sebastianbeyer/KOSMO_Roundhouse/kickall.kicad_pcb

## KiCad design kickall.kicad_pcb (2022-11-23)

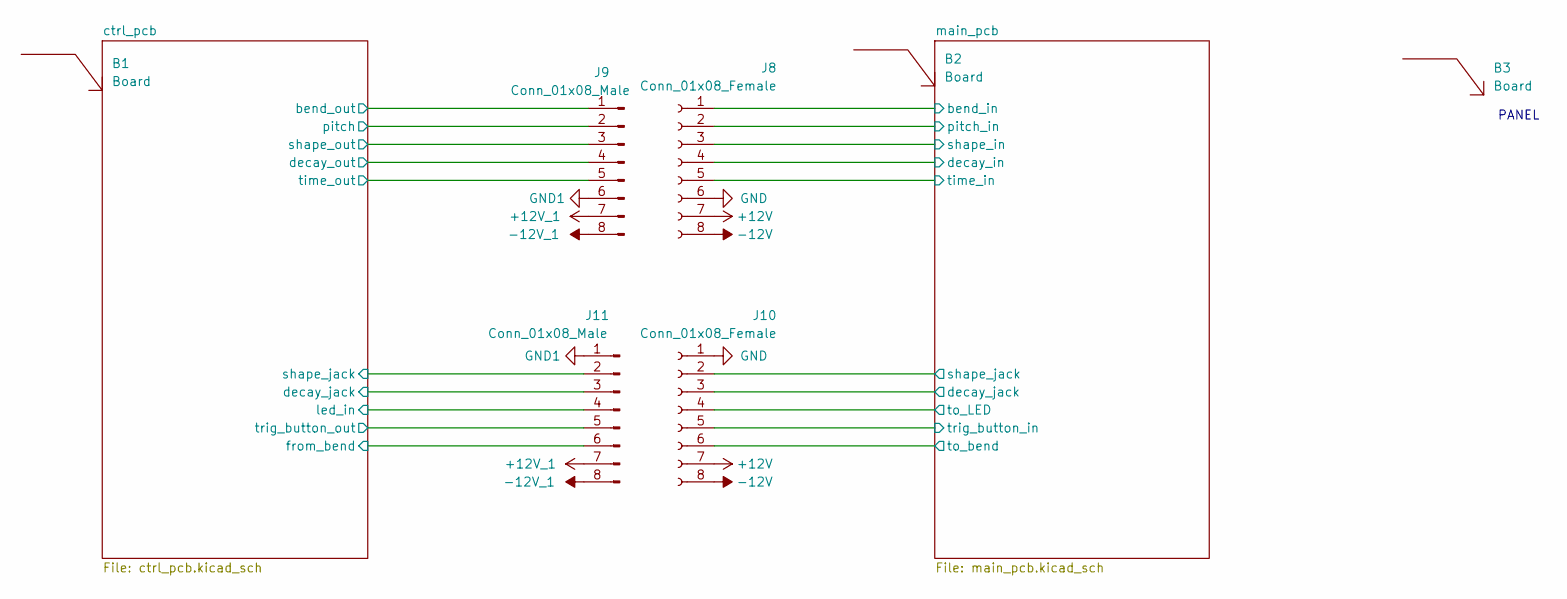
[picture p1: schematic kickall.kicad_sch, Roundhouse]

Parts:
B1, B2, B3: Board; Board_Marker
J8, J10: Conn_01x08_Female; PinSocket_1x08_P2.54mm_Vertical
J9, J11: Conn_01x08_Male; PinHeader_1x08_P2.54mm_Vertical

Connections:
+12V: J8.7, J10.7; also elsewhere on the board
+12V_1: J9.7, J11.7; also elsewhere on the board
-12V: J8.8, J10.8; also elsewhere on the board
-12V_1: J9.8, J11.8; also elsewhere on the board
/ctrl_pcb/bend_out: J9.1; also elsewhere on the board
/ctrl_pcb/decay_jack: J11.3; also elsewhere on the board
/ctrl_pcb/decay_out: J9.4; also elsewhere on the board
/ctrl_pcb/from_bend: J11.6; also elsewhere on the board
/ctrl_pcb/led_in: J11.4; also elsewhere on the board
/ctrl_pcb/pitch: J9.2; also elsewhere on the board
/ctrl_pcb/shape_jack: J11.2; also elsewhere on the board
/ctrl_pcb/shape_out: J9.3; also elsewhere on the board
/ctrl_pcb/time_out: J9.5; also elsewhere on the board
/ctrl_pcb/trig_button_out: J11.5; also elsewhere on the board
/main_pcb/bend_in: J8.1; also elsewhere on the board
/main_pcb/decay_in: J8.4; also elsewhere on the board
/main_pcb/decay_jack: J10.3; also elsewhere on the board
/main_pcb/pitch_in: J8.2; also elsewhere on the board
/main_pcb/shape_in: J8.3; also elsewhere on the board
/main_pcb/shape_jack: J10.2; also elsewhere on the board
/main_pcb/time_in: J8.5; also elsewhere on the board
/main_pcb/to_LED: J10.4; also elsewhere on the board
/main_pcb/to_bend: J10.6; also elsewhere on the board
/main_pcb/trig_button_in: J10.5; also elsewhere on the board
GND: J8.6, J10.1; also elsewhere on the board
GND1: J9.6, J11.1; also elsewhere on the board

Notes on the sheet:
PANEL

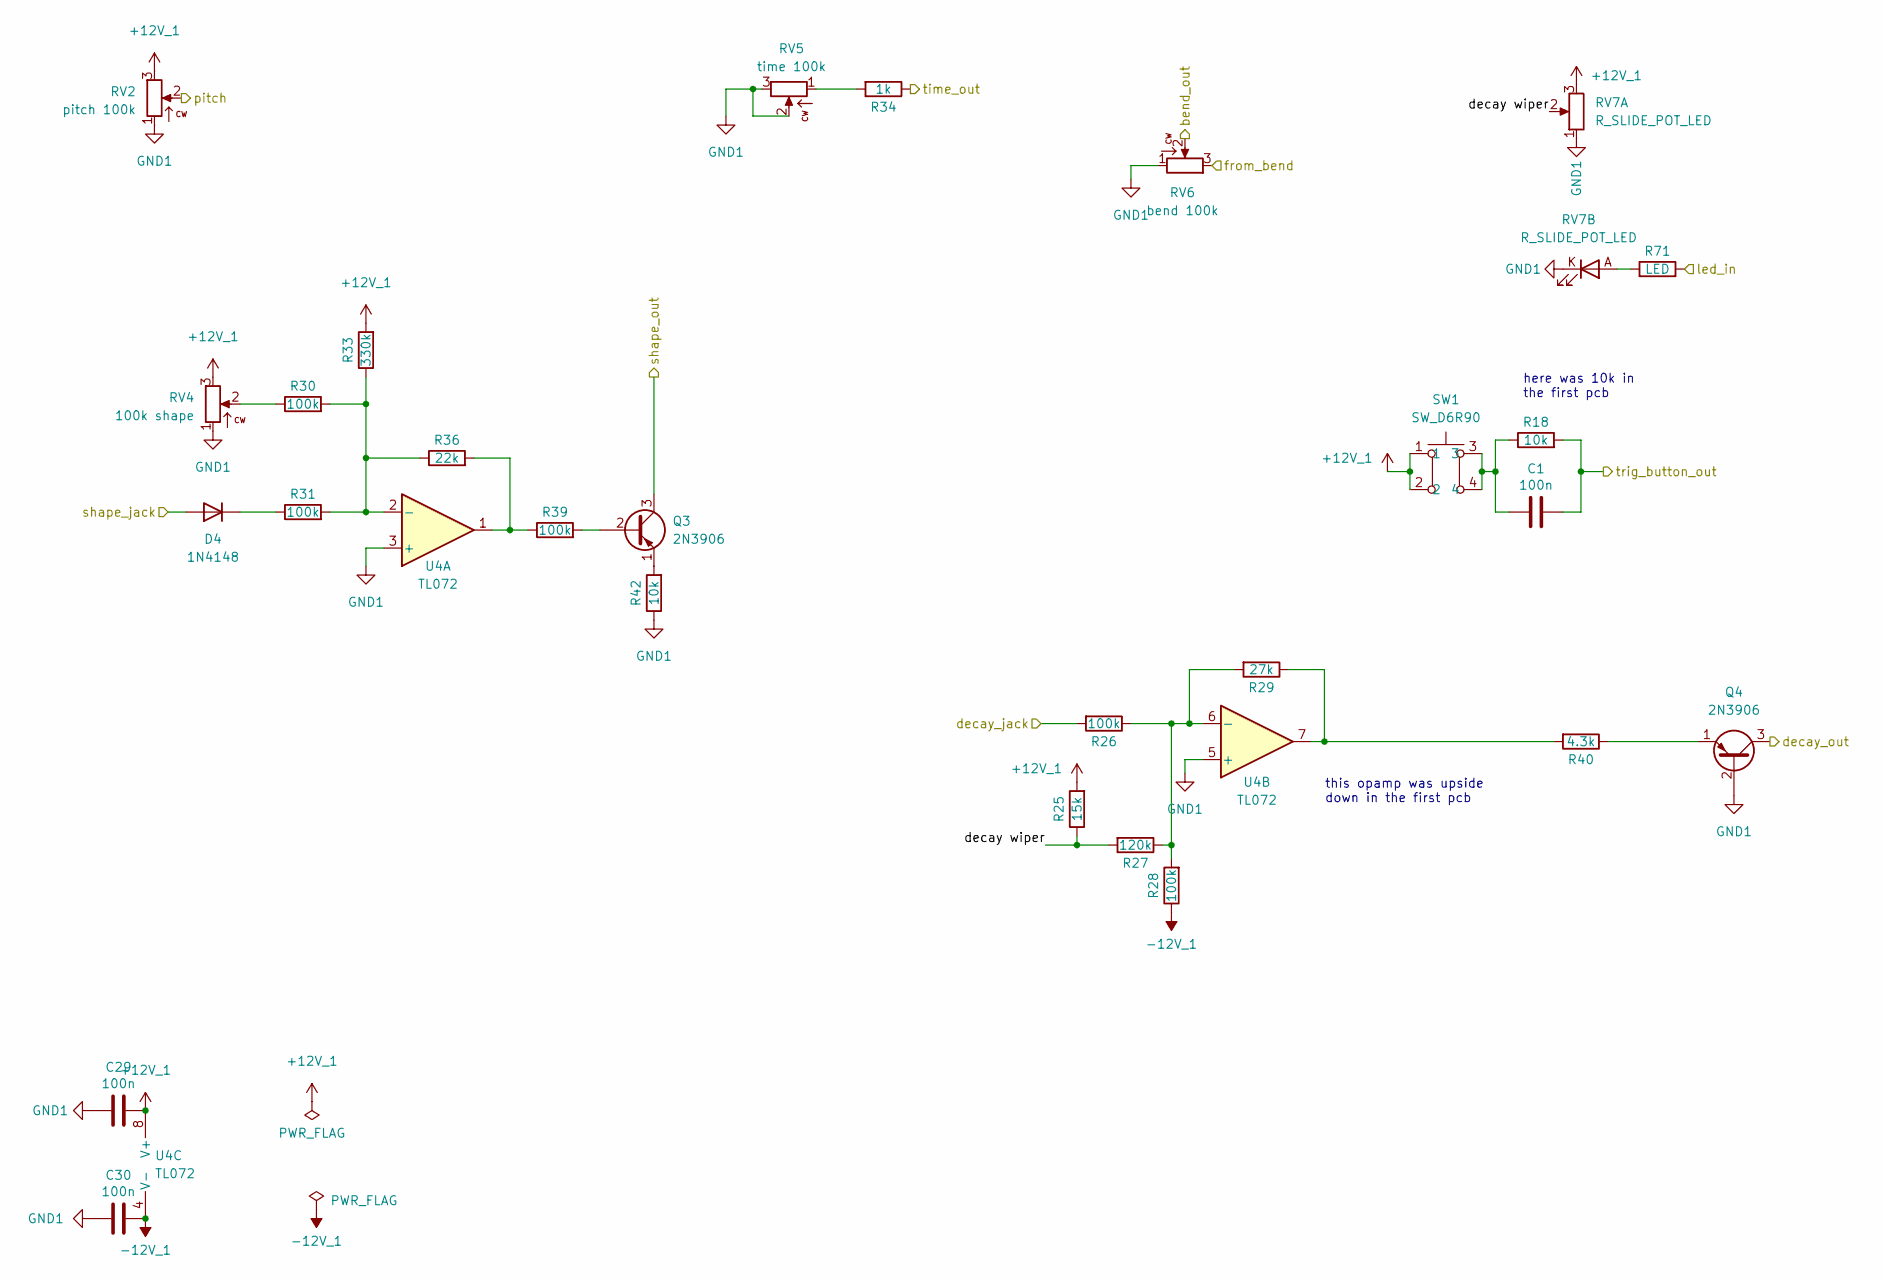
[picture p2: schematic ctrl_pcb.kicad_sch]

Parts:
C1, C29, C30: 100n; C_Disc_D3.0mm_W1.6mm_P2.50mm
D4: 1N4148; D_DO-35_SOD27_P7.62mm_Horizontal
Q3, Q4: 2N3906; TO-92_Inline_Wide
R18, R42: 10k; R_Axial_DIN0207_L6.3mm_D2.5mm_P10.16mm_Horizontal
R25: 15k; R_Axial_DIN0207_L6.3mm_D2.5mm_P10.16mm_Horizontal
R26, R28, R30, R31, R39: 100k; R_Axial_DIN0207_L6.3mm_D2.5mm_P10.16mm_Horizontal
R27: 120k; R_Axial_DIN0207_L6.3mm_D2.5mm_P10.16mm_Horizontal
R29: 27k; R_Axial_DIN0207_L6.3mm_D2.5mm_P10.16mm_Horizontal
R33: 330k; R_Axial_DIN0207_L6.3mm_D2.5mm_P10.16mm_Horizontal
R34: 1k; R_Axial_DIN0207_L6.3mm_D2.5mm_P10.16mm_Horizontal
R36: 22k; R_Axial_DIN0207_L6.3mm_D2.5mm_P10.16mm_Horizontal
R40: 4.3k; R_Axial_DIN0207_L6.3mm_D2.5mm_P10.16mm_Horizontal
R71: LED; R_Axial_DIN0207_L6.3mm_D2.5mm_P10.16mm_Horizontal
RV2: pitch 100k; Potentiometer_Alpha_RD901F-40-00D_Single_Vertical_centered
RV4: 100k shape; Potentiometer_Alpha_RD901F-40-00D_Single_Vertical_centered
RV5: time 100k; Potentiometer_Alpha_RD901F-40-00D_Single_Vertical_centered
RV6: bend 100k; Potentiometer_Alpha_RD901F-40-00D_Single_Vertical_centered
RV7: R_SLIDE_POT_LED; Potentiometer_Bourns_PTL6015_Single_Slide_LED_walpha
SW1: SW_D6R90; SW_D6R90_F1_LFS
U4: TL072; DIP-8_W7.62mm_Socket_LongPads

Connections:
+12V_1: C29.2, R25.2, R33.2, RV2.3, RV4.3, RV7.3, SW1.1, SW1.2, U4.8 (V+); also elsewhere on the board
-12V_1: C30.2, R28.1, U4.4 (V-); also elsewhere on the board
/ctrl_pcb/bend_out: RV6.2; also elsewhere on the board
/ctrl_pcb/decay wiper: R25.1, R27.2, RV7.2
/ctrl_pcb/decay_jack: R26.2; also elsewhere on the board
/ctrl_pcb/decay_out: Q4.3 (C); also elsewhere on the board
/ctrl_pcb/from_bend: RV6.3; also elsewhere on the board
/ctrl_pcb/led_in: R71.2; also elsewhere on the board
/ctrl_pcb/pitch: RV2.2; also elsewhere on the board
/ctrl_pcb/shape_jack: D4.2 (A); also elsewhere on the board
/ctrl_pcb/shape_out: Q3.3 (C); also elsewhere on the board
/ctrl_pcb/time_out: R34.1; also elsewhere on the board
/ctrl_pcb/trig_button_out: C1.2, R18.2; also elsewhere on the board
GND1: C29.1, C30.1, Q4.2 (B), R42.1, RV2.1, RV4.1, RV5.2, RV5.3, RV6.1, RV7.1, RV7.K, U4.3 (+), U4.5 (+); also elsewhere on the board
unnamed: C1.1, R18.1, SW1.3, SW1.4
unnamed: D4.1 (K), R31.1
unnamed: Q3.1 (E), R42.2
unnamed: Q3.2 (B), R39.2
unnamed: Q4.1 (E), R40.1
unnamed: R26.1, R27.1, R28.2, R29.2, U4.6 (-)
unnamed: R29.1, R40.2, U4.7
unnamed: R30.1, RV4.2
unnamed: R30.2, R31.2, R33.1, R36.1, U4.2 (-)
unnamed: R34.2, RV5.1
unnamed: R36.2, R39.1, U4.1
unnamed: R71.1, RV7.A

Notes on the sheet:
here was 10k in the first pcb
this opamp was upside down in the first pcb

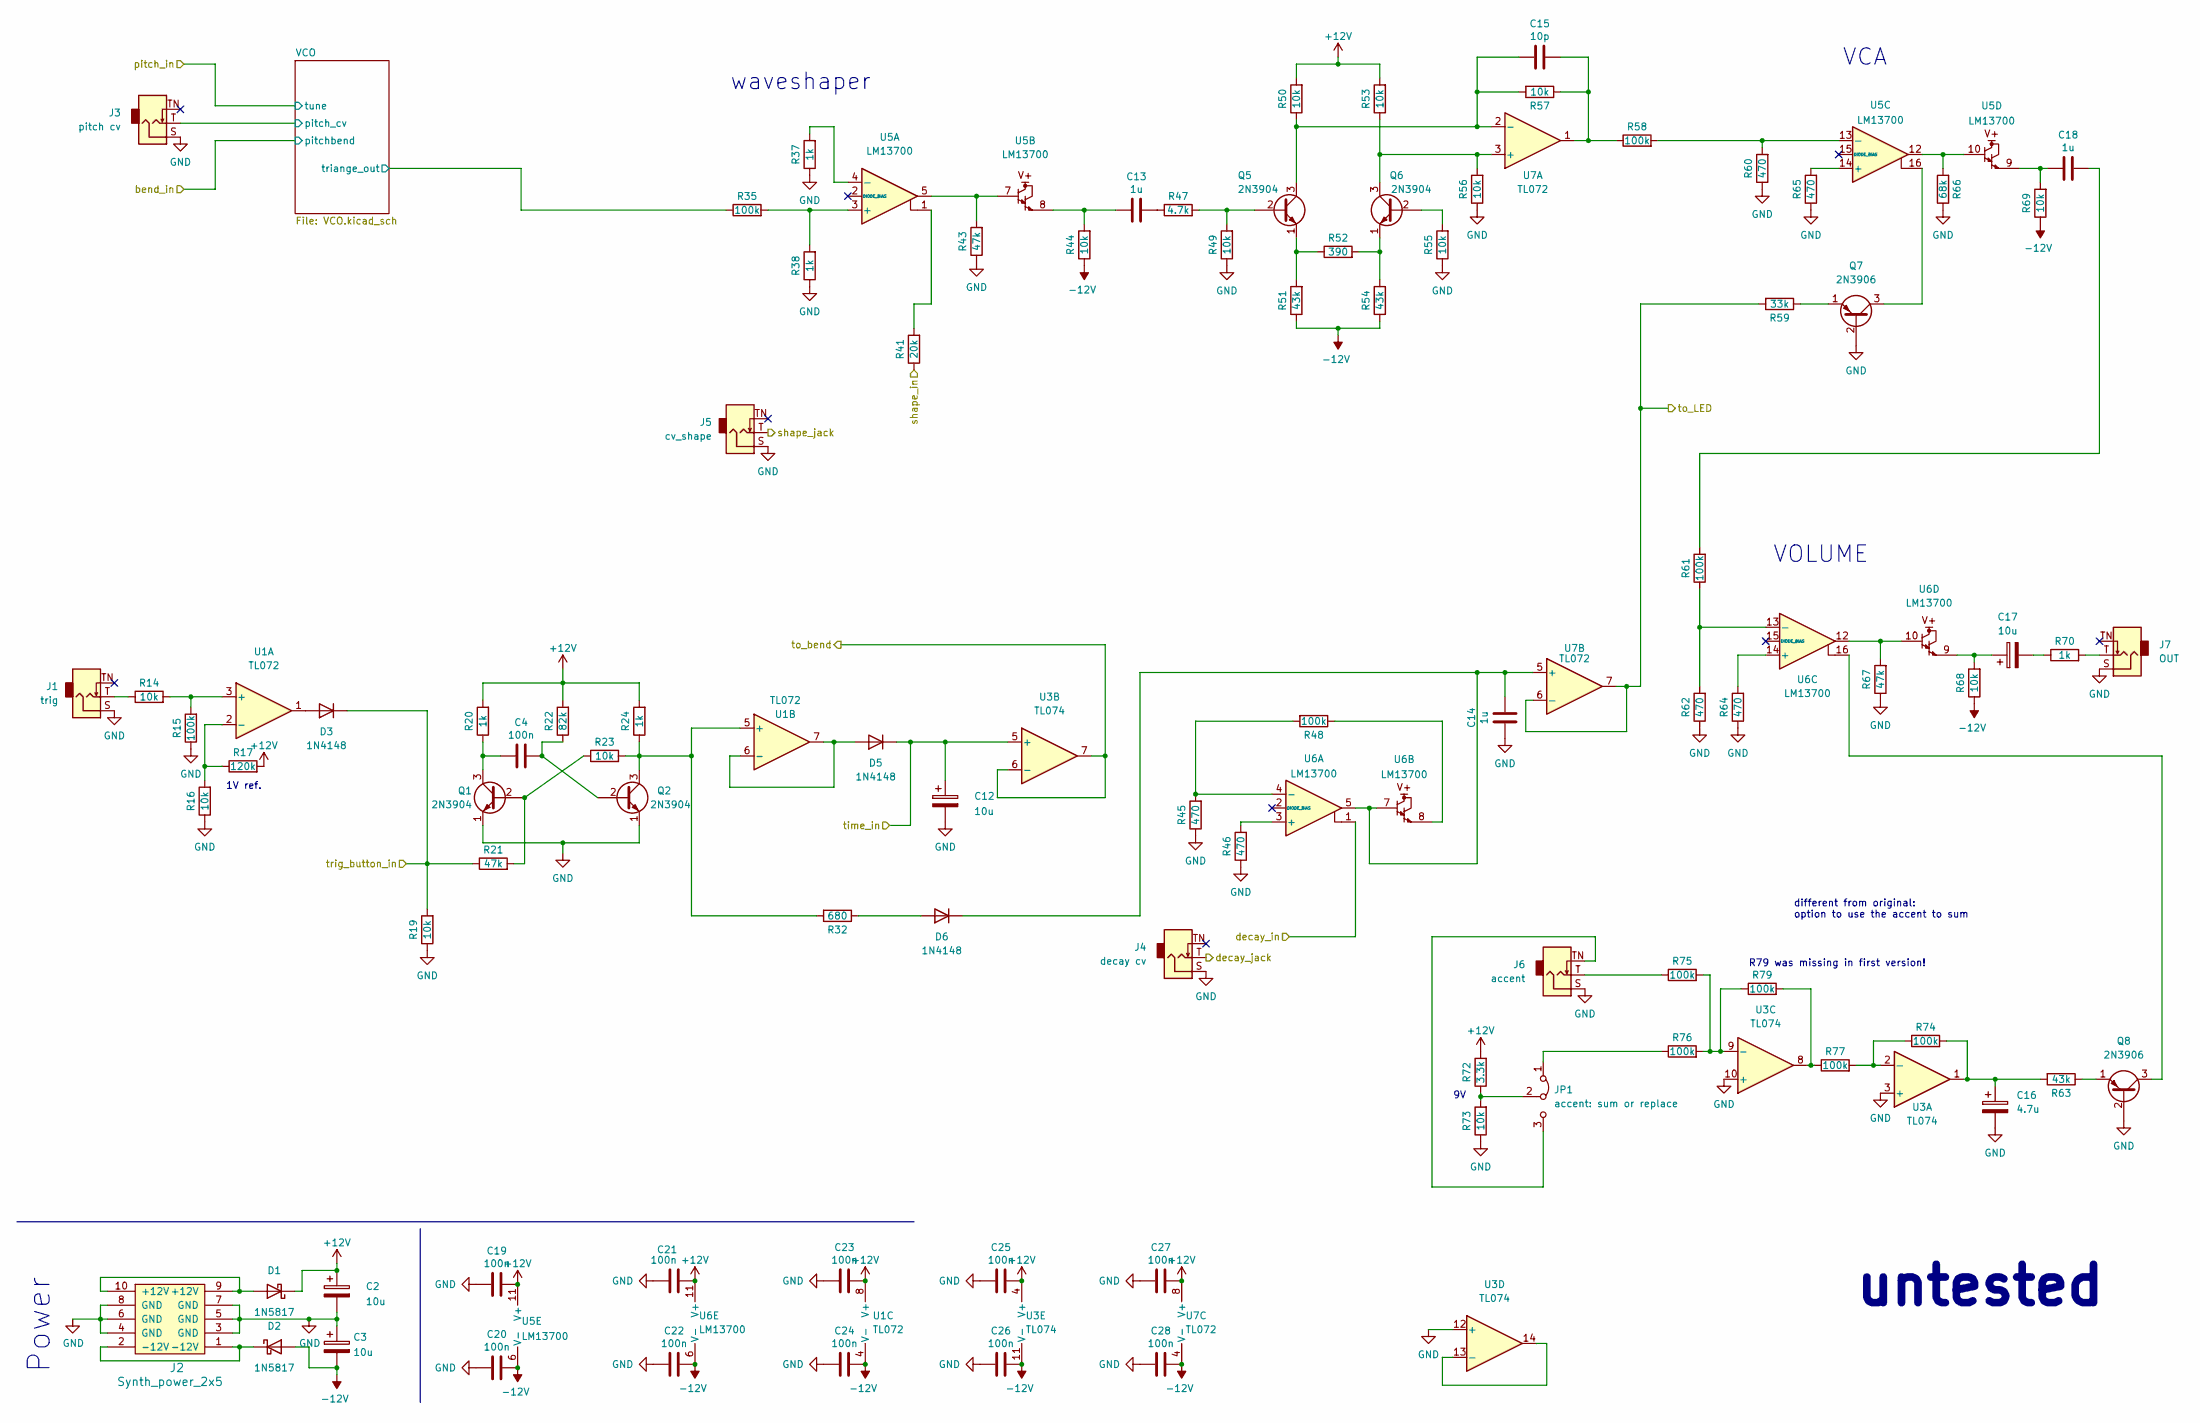
[picture p3: schematic main_pcb.kicad_sch, Roundhouse]

Parts:
C2, C3, C12, C17: 10u; CP_Radial_horizontalflat_D5mm_P2.50mm_H10mm_south
C4, C19, C20, C21, C22, C23, C24, C25, C26, C27, C28: 100n; C_Disc_D3.0mm_W1.6mm_P2.50mm
C13, C14, C18: 1u; C_Rect_L7.2mm_W7.2mm_P5.00mm_FKS2_FKP2_MKS2_MKP2
C15: 10p; C_Disc_D3.0mm_W1.6mm_P2.50mm
C16: 4.7u; CP_Radial_horizontalflat_D5mm_P2.50mm_H10mm_south
D1, D2: 1N5817; D_DO-41_SOD81_P10.16mm_Horizontal
D3, D5, D6: 1N4148; D_DO-35_SOD27_P7.62mm_Horizontal
J1: trig; Jack_6.35mm_PJ_629HAN_slots
J2: Synth_power_2x5; Power_Header
J3: pitch cv; Jack_6.35mm_PJ_629HAN_slots
J4: decay cv; Jack_6.35mm_PJ_629HAN_slots
J5: cv_shape; Jack_6.35mm_PJ_629HAN_slots
J6: accent; Jack_6.35mm_PJ_629HAN_slots
J7: OUT; Jack_6.35mm_PJ_629HAN_slots
JP1: accent: sum or replace; PinHeader_1x03_P2.54mm_Vertical
Q1, Q2, Q5, Q6: 2N3904; TO-92_Inline_Wide
Q7, Q8: 2N3906; TO-92_Inline_Wide
R14, R16, R19, R23, R44, R49, R50, R53, R55, R56, R57, R68, R69, R73: 10k; R_Axial_DIN0207_L6.3mm_D2.5mm_P10.16mm_Horizontal
R15, R35, R48, R58, R61, R74, R75, R76, R77, R79: 100k; R_Axial_DIN0207_L6.3mm_D2.5mm_P10.16mm_Horizontal
R17: 120k; R_Axial_DIN0207_L6.3mm_D2.5mm_P10.16mm_Horizontal
R20, R24, R37, R38, R70: 1k; R_Axial_DIN0207_L6.3mm_D2.5mm_P10.16mm_Horizontal
R21, R43, R67: 47k; R_Axial_DIN0207_L6.3mm_D2.5mm_P10.16mm_Horizontal
R22: 82k; R_Axial_DIN0207_L6.3mm_D2.5mm_P10.16mm_Horizontal
R32: 680; R_Axial_DIN0207_L6.3mm_D2.5mm_P10.16mm_Horizontal
R41: 20k; R_Axial_DIN0207_L6.3mm_D2.5mm_P10.16mm_Horizontal
R45, R46, R60, R62, R64, R65: 470; R_Axial_DIN0207_L6.3mm_D2.5mm_P10.16mm_Horizontal
R47: 4.7k; R_Axial_DIN0207_L6.3mm_D2.5mm_P10.16mm_Horizontal
R51, R54, R63: 43k; R_Axial_DIN0207_L6.3mm_D2.5mm_P10.16mm_Horizontal
R52: 390; R_Axial_DIN0207_L6.3mm_D2.5mm_P10.16mm_Horizontal
R59: 33k; R_Axial_DIN0207_L6.3mm_D2.5mm_P10.16mm_Horizontal
R66: 68k; R_Axial_DIN0207_L6.3mm_D2.5mm_P10.16mm_Horizontal
R72: 3.3k; R_Axial_DIN0207_L6.3mm_D2.5mm_P10.16mm_Horizontal
U1, U7: TL072; DIP-8_W7.62mm_Socket_LongPads
U3: TL074; DIP-14_W7.62mm_Socket_LongPads
U5, U6: LM13700; DIP-16_W7.62mm_Socket_LongPads

Connections:
+12V: C2.1, C19.2, C21.2, C23.2, C25.2, C27.2, D1.1 (K), R17.2, R20.2, R22.2, R24.2, R50.2, R53.2, R72.2, U1.8 (V+), U3.4 (V+), U5.11 (V+), U6.11 (V+), U7.8 (V+); also elsewhere on the board
-12V: C3.2, C20.2, C22.2, C24.2, C26.2, C28.2, D2.2 (A), R44.1, R51.1, R54.1, R68.1, R69.1, U1.4 (V-), U3.11 (V-), U5.6 (V-), U6.6 (V-), U7.4 (V-); also elsewhere on the board
/main_pcb/VCO/pitch_cv: J3.T; also elsewhere on the board
/main_pcb/VCO/triange_out: R35.1; also elsewhere on the board
/main_pcb/decay_in: U6.1; also elsewhere on the board
/main_pcb/decay_jack: J4.T; also elsewhere on the board
/main_pcb/shape_in: R41.1; also elsewhere on the board
/main_pcb/shape_jack: J5.T; also elsewhere on the board
/main_pcb/time_in: C12.1, D5.1 (K), U3.5 (+); also elsewhere on the board
/main_pcb/to_LED: R59.2, U7.6 (-), U7.7; also elsewhere on the board
/main_pcb/to_bend: U3.6 (-), U3.7; also elsewhere on the board
/main_pcb/trig_button_in: D3.1 (K), R19.2, R21.1; also elsewhere on the board
GND: C2.2, C3.1, C12.2, C14.1, C16.2, C19.1, C20.1, C21.1, C22.1, C23.1, C24.1, C25.1, C26.1, C27.1, C28.1, J1.S, J2.3 (GND), J2.4 (GND), J2.5 (GND), J2.6 (GND), J2.7 (GND), J2.8 (GND), J3.S, J4.S, J5.S, J6.S, J7.S, Q1.1 (E), Q2.1 (E), Q7.2 (B), Q8.2 (B), R15.1, R16.1, R19.1, R37.1, R38.1, R43.1, R45.1, R46.1, R49.1, R55.1, R56.1, R60.1, R62.1, R64.1, R65.1, R66.1, R67.1, R73.1, U3.3 (+), U3.10 (+), U3.12 (+); also elsewhere on the board
unnamed: C4.1, Q1.3 (C), R20.1
unnamed: C4.2, Q2.2 (B), R22.1
unnamed: C13.1, R44.2, U5.8
unnamed: C13.2, R47.1
unnamed: C14.2, D6.1 (K), U6.5, U6.7, U7.5 (+)
unnamed: C15.1, Q5.3 (C), R50.1, R57.2, U7.2 (-)
unnamed: C15.2, R57.1, R58.1, U7.1
unnamed: C16.1, R63.2, R74.2, U3.1
unnamed: C17.1, R68.2, U6.9
unnamed: C17.2, R70.1
unnamed: C18.1, R69.2, U5.9
unnamed: C18.2, R61.2
unnamed: D1.2 (A), J2.9 (+12V), J2.10 (+12V)
unnamed: D2.1 (K), J2.1 (-12V), J2.2 (-12V)
unnamed: D3.2 (A), U1.1
unnamed: D5.2 (A), U1.6 (-), U1.7
unnamed: D6.2 (A), R32.1
unnamed: J1.T, R14.1
unnamed: J6.T, R75.1
unnamed: J6.TN, JP1.3 (B)
unnamed: J7.T, R70.2
unnamed: JP1.1 (A), R76.1
unnamed: JP1.2 (C), R72.1, R73.2
unnamed: Q1.2 (B), R21.2, R23.1
unnamed: Q2.3 (C), R23.2, R24.1, R32.2, U1.5 (+)
unnamed: Q5.1 (E), R51.2, R52.1
unnamed: Q5.2 (B), R47.2, R49.2
unnamed: Q6.1 (E), R52.2, R54.2
unnamed: Q6.2 (B), R55.2
unnamed: Q6.3 (C), R53.1, R56.2, U7.3 (+)
unnamed: Q7.1 (E), R59.1
unnamed: Q7.3 (C), U5.16
unnamed: Q8.1 (E), R63.1
unnamed: Q8.3 (C), U6.16
unnamed: R14.2, R15.2, U1.3 (+)
unnamed: R16.2, R17.1, U1.2 (-)
unnamed: R35.2, R38.2, U5.3 (+)
unnamed: R37.2, U5.4 (-)
unnamed: R41.2, U5.1
unnamed: R43.2, U5.5, U5.7
unnamed: R45.2, R48.2, U6.4 (-)
unnamed: R46.2, U6.3 (+)
unnamed: R48.1, U6.8
unnamed: R58.2, R60.2, U5.13 (-)
unnamed: R61.1, R62.2, U6.13 (-)
unnamed: R64.2, U6.14 (+)
unnamed: R65.2, U5.14 (+)
unnamed: R66.2, U5.10, U5.12
unnamed: R67.2, U6.10, U6.12
unnamed: R74.1, R77.2, U3.2 (-)
unnamed: R75.2, R76.2, R79.1, U3.9 (-)
unnamed: R77.1, R79.2, U3.8
unnamed: U3.13 (-), U3.14

Notes on the sheet:
different from original: option to use the accent to sum
R79 was missing in first version!
1V ref.
waveshaper
VCA
VOLUME
untested
Power

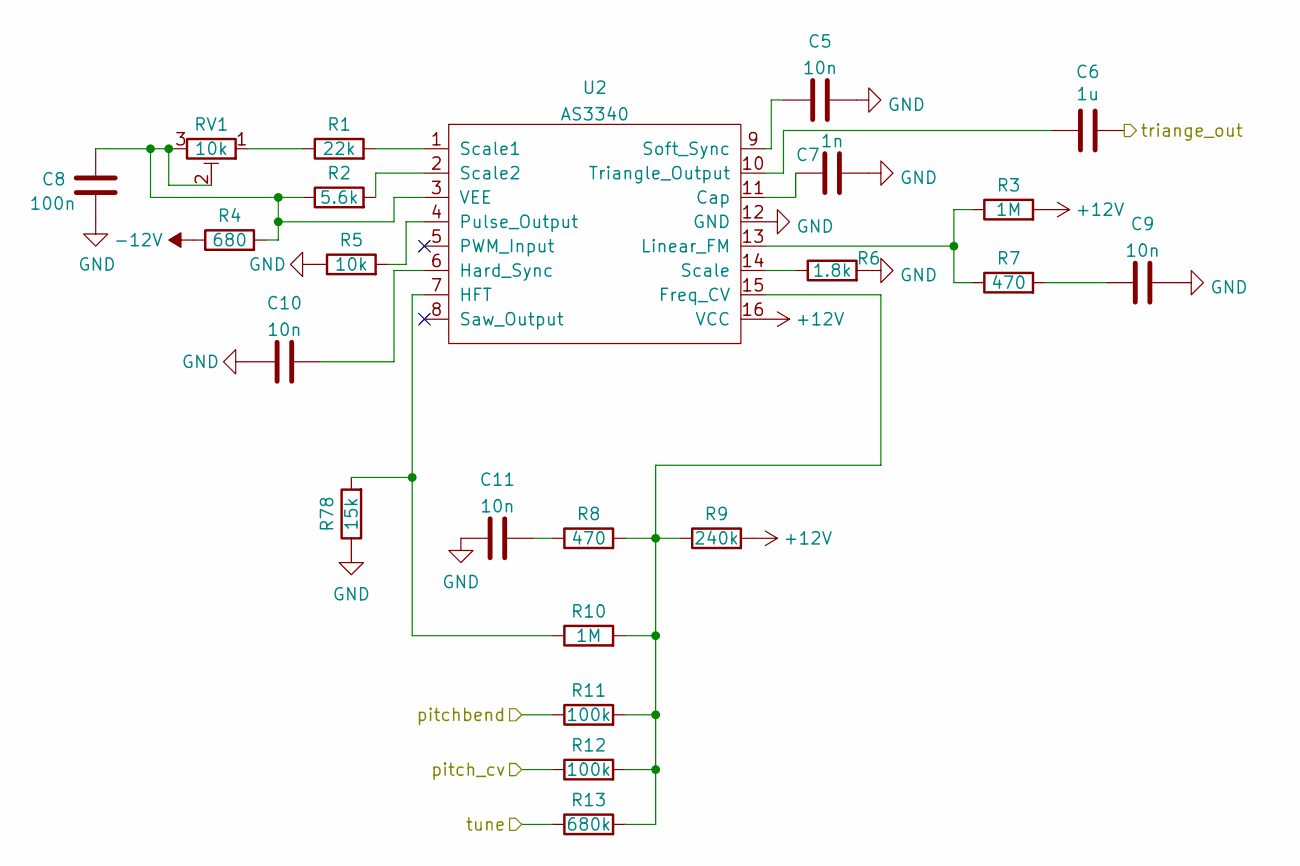
[picture p4: schematic VCO.kicad_sch]

Parts:
C5, C9, C10, C11: 10n; C_Disc_D3.0mm_W1.6mm_P2.50mm
C6: 1u; C_Rect_L7.2mm_W7.2mm_P5.00mm_FKS2_FKP2_MKS2_MKP2
C7: 1n; C_Disc_D3.0mm_W1.6mm_P2.50mm
C8: 100n; C_Disc_D3.0mm_W1.6mm_P2.50mm
R1: 22k; R_Axial_DIN0207_L6.3mm_D2.5mm_P10.16mm_Horizontal
R2: 5.6k; R_Axial_DIN0207_L6.3mm_D2.5mm_P10.16mm_Horizontal
R3, R10: 1M; R_Axial_DIN0207_L6.3mm_D2.5mm_P10.16mm_Horizontal
R4: 680; R_Axial_DIN0207_L6.3mm_D2.5mm_P10.16mm_Horizontal
R5: 10k; R_Axial_DIN0207_L6.3mm_D2.5mm_P10.16mm_Horizontal
R6: 1.8k; R_Axial_DIN0207_L6.3mm_D2.5mm_P10.16mm_Horizontal
R7, R8: 470; R_Axial_DIN0207_L6.3mm_D2.5mm_P10.16mm_Horizontal
R9: 240k; R_Axial_DIN0207_L6.3mm_D2.5mm_P10.16mm_Horizontal
R11, R12: 100k; R_Axial_DIN0207_L6.3mm_D2.5mm_P10.16mm_Horizontal
R13: 680k; R_Axial_DIN0207_L6.3mm_D2.5mm_P10.16mm_Horizontal
R78: 15k; R_Axial_DIN0207_L6.3mm_D2.5mm_P10.16mm_Horizontal
RV1: 10k; Potentiometer_Bourns_3296Z_Horizontal
U2: AS3340; DIP-16_W7.62mm_Socket_LongPads

Connections:
+12V: R3.2, R9.2, U2.16 (VCC); also elsewhere on the board
-12V: R4.1; also elsewhere on the board
/main_pcb/VCO/pitch_cv: R12.1; also elsewhere on the board
/main_pcb/VCO/triange_out: C6.2; also elsewhere on the board
/main_pcb/bend_in: R11.1; also elsewhere on the board
/main_pcb/pitch_in: R13.1; also elsewhere on the board
GND: C5.2, C7.2, C8.1, C9.2, C10.1, C11.1, R5.1, R6.2, R78.1, U2.12 (GND); also elsewhere on the board
unnamed: C5.1, U2.9 (Soft_Sync)
unnamed: C6.1, U2.10 (Triangle_Output)
unnamed: C7.1, U2.11 (Cap)
unnamed: C8.2, R2.1, R4.2, RV1.2, RV1.3, U2.3 (VEE)
unnamed: C9.1, R7.2
unnamed: C10.2, U2.6 (Hard_Sync)
unnamed: C11.2, R8.1
unnamed: R1.1, RV1.1
unnamed: R1.2, U2.1 (Scale1)
unnamed: R2.2, U2.2 (Scale2)
unnamed: R3.1, R7.1, U2.13 (Linear_FM)
unnamed: R5.2, U2.4 (Pulse_Output)
unnamed: R6.1, U2.14 (Scale)
unnamed: R10.1, R78.2, U2.7 (HFT)
unnamed: R8.2, R9.1, R10.2, R11.2, R12.2, R13.2, U2.15 (Freq_CV)

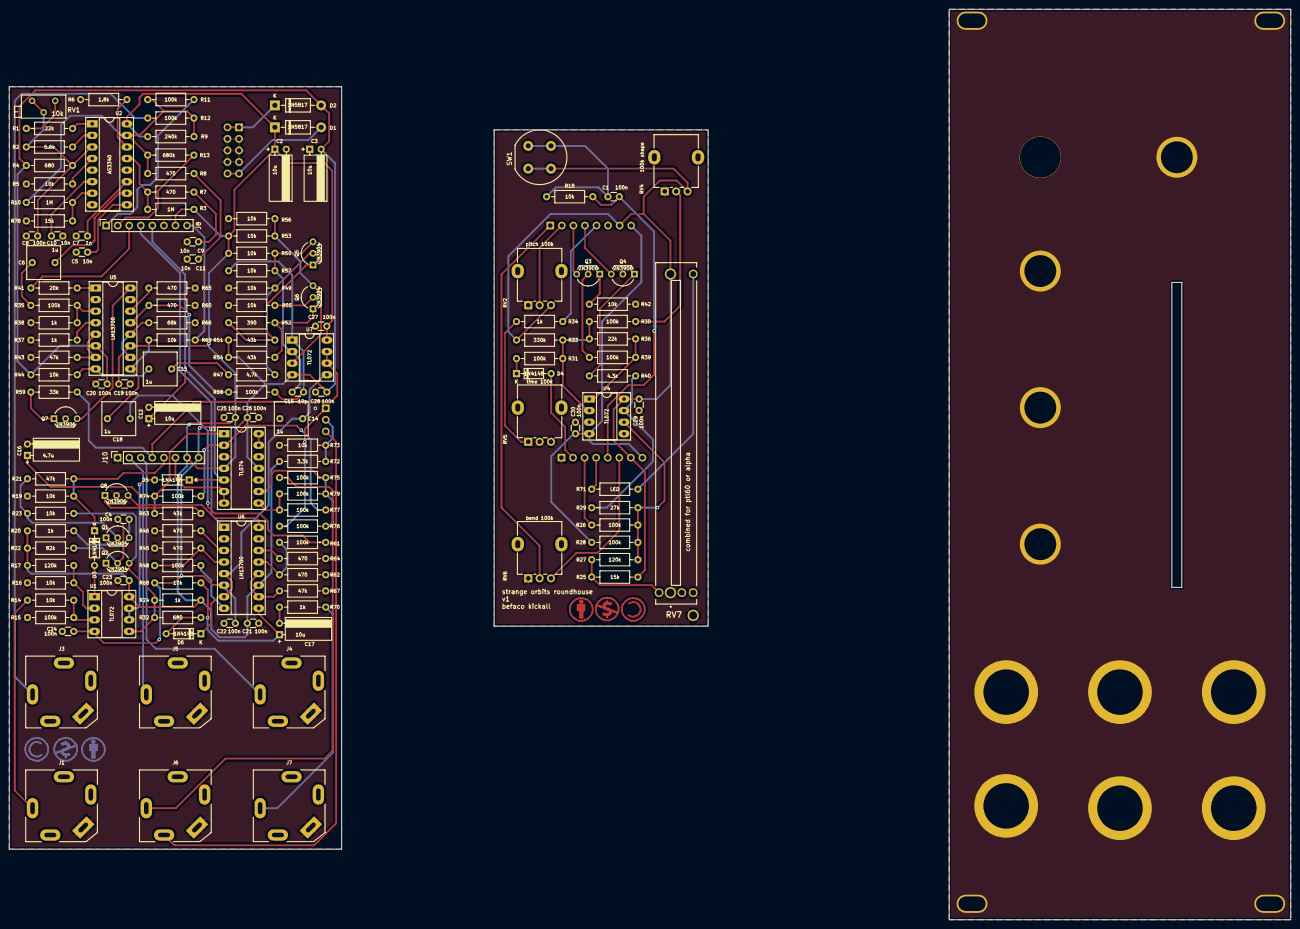
[picture p5: board kickall.kicad_pcb from above]

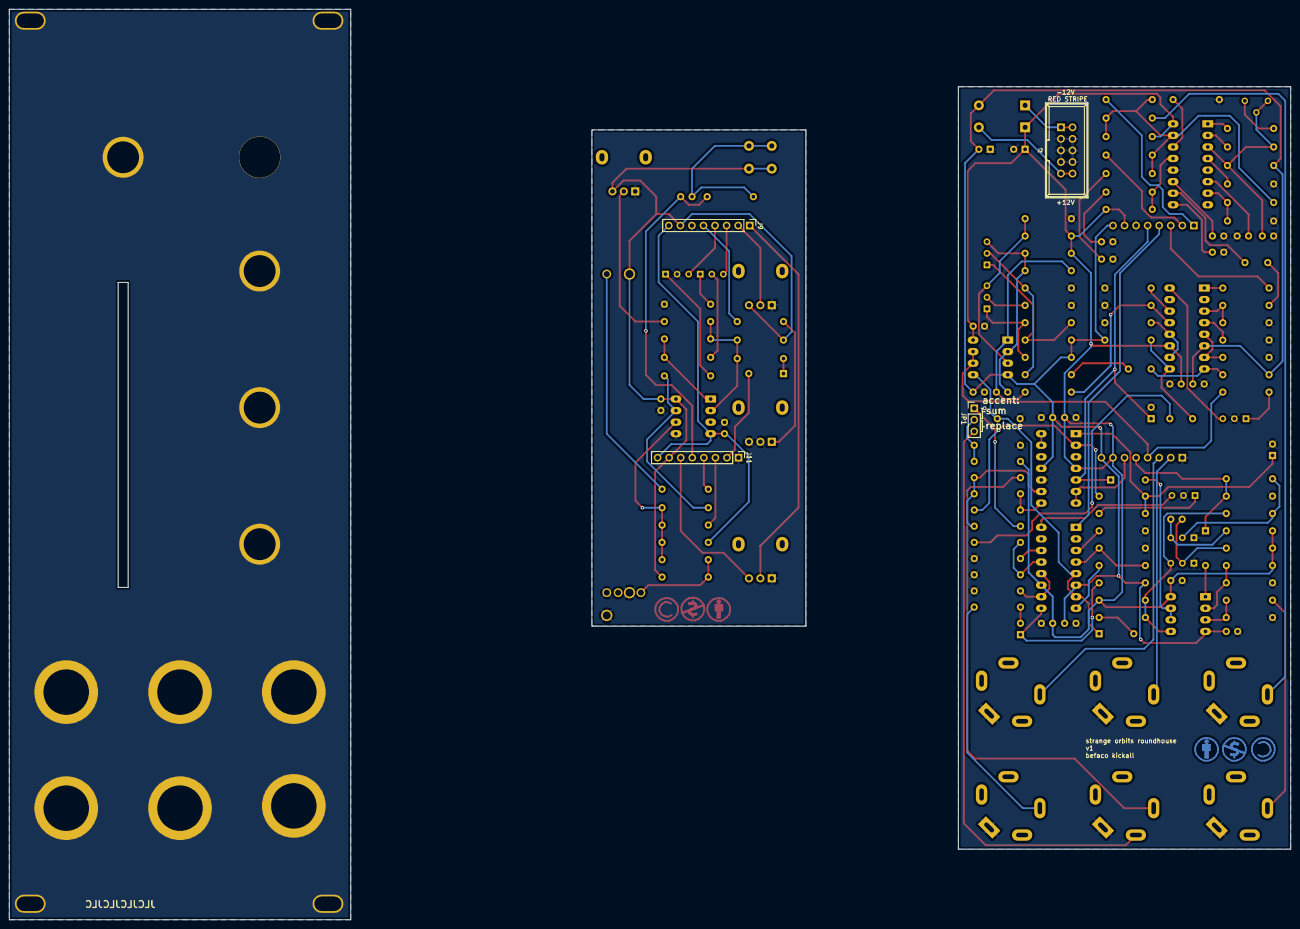
[picture p6: board kickall.kicad_pcb from below]

Board: 2 copper layers, 281.5 x 200.0 mm, 158 parts (7 on the bottom side), 109 nets.

Other parts of the board:
 : Symbol_CC-ShareAlike_CopperTop_Small
  : Symbol_CC-Attribution_CopperTop_Small
  #2: Symbol_CC-ShareAlike_CopperTop_Small
  #3: Symbol_CC-Noncommercial_CopperTop_Small
  #4: Symbol_CC-Attribution_CopperTop_Small
 #2: Symbol_CC-Noncommercial_CopperTop_Small
